nakujaproject/internship2024-2/SOLID PROPULSION/WEEKLY REPORTS/Week 1 and 2 Progress Report_compressed.pdf

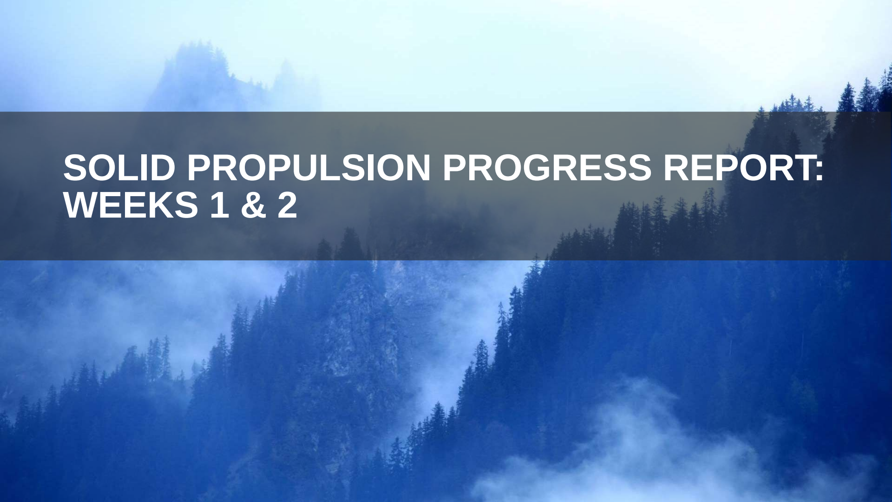
[picture p1: page 1]

## SOLID PROPULSION PROGRESS REPORT: WEEKS 1 & 2

## Week 1 Objectives

### - Orientation - Go through the theory of solid motors - Help in N3.5 launch preparation - Understand N3.5 propulsion system

### Tasks completed in week 1

- Attending orientation meetings
- Reading solid motor theory - Richard Nakka
- Helped N3.5 team prepare for launch
- Installation and training on necessary software -Solidworks, Open Motor, Ansys, etc
- Solid propulsion system characterization for N3.5

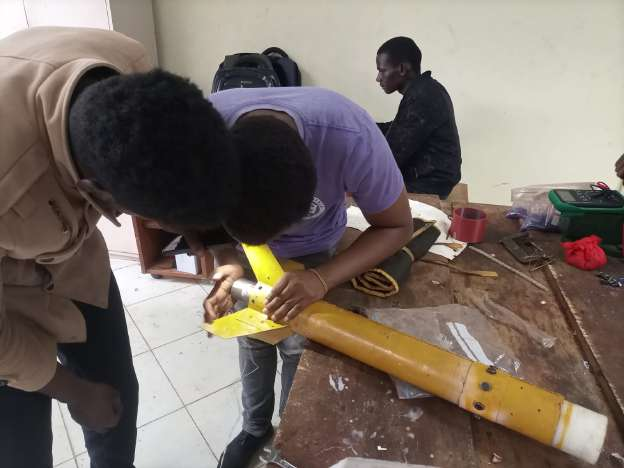
[picture p2: figure]
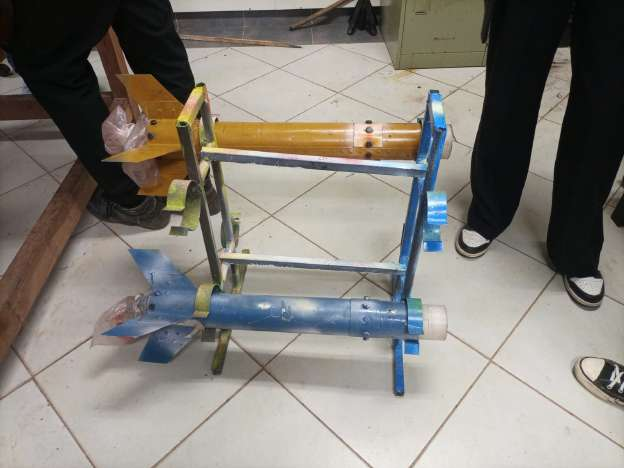
[picture p3: figure]

## Week 2 Objectives

### - Benchmarking solid motor designs - Estimation of required impulse for target apogee - Casing Design - Design of grains and nozzle parameters using Open Motor - Ansys Simulation of flow through nozzle - Design of grain casting tools - Improvements and SA Cup Requirements - Design of Casting Tools

### Tasks Completed in week 2

Benchmarking of SRM designs

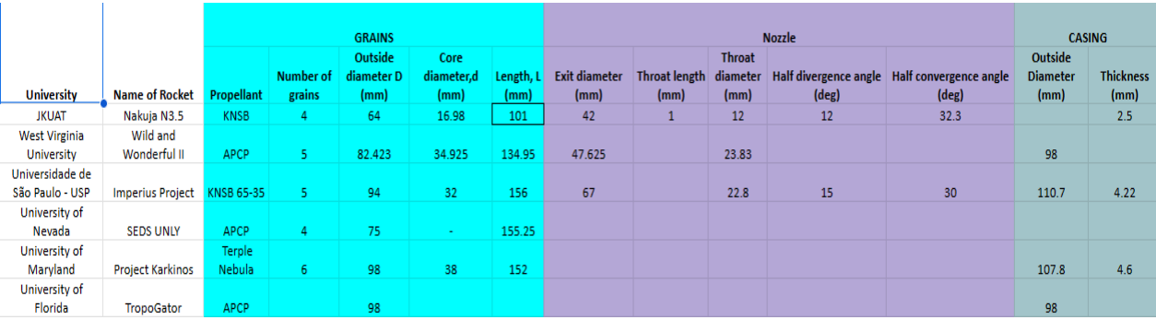
[picture p4: figure]

### Impulse estimation

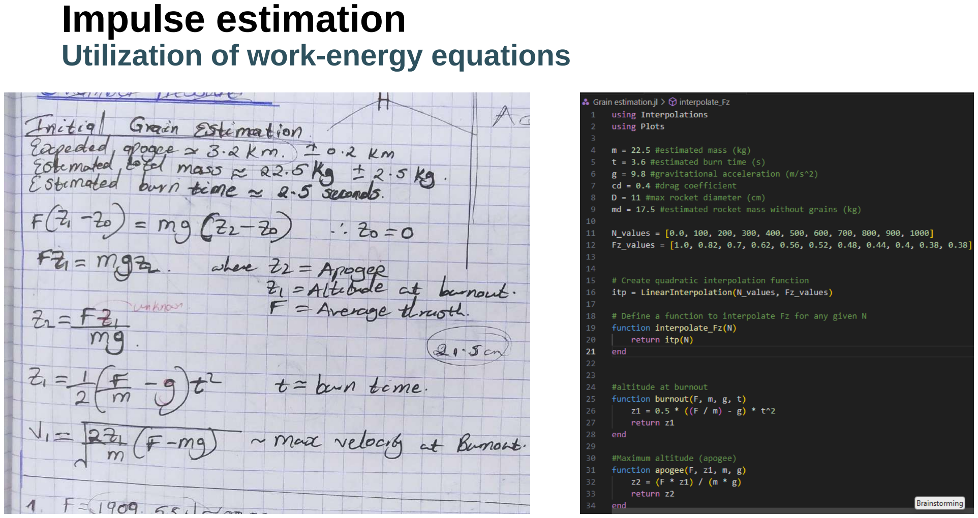
[picture p5: page 6]

Utilization of work-energy equations

Apogee Estimation Results

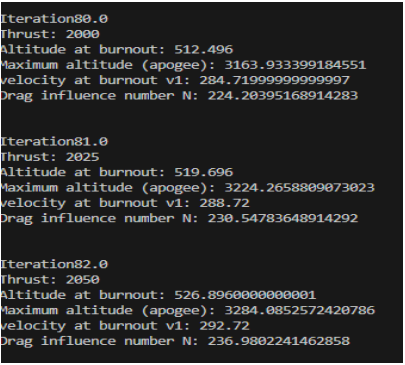
[picture p6: figure]

Burn time (estimate) = 3.6 s

Avg thrust required = 2025 N

Impulse required = 7290 Ns

### Casing Design

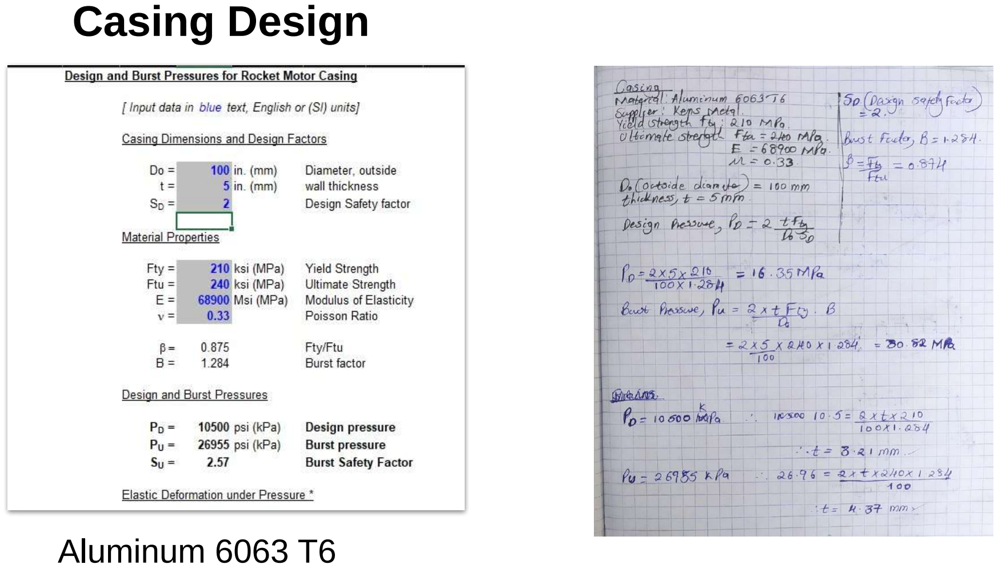
[picture p7: page 8]

Aluminum 6063 T6

### Design of Grains and Nozzle Parameters

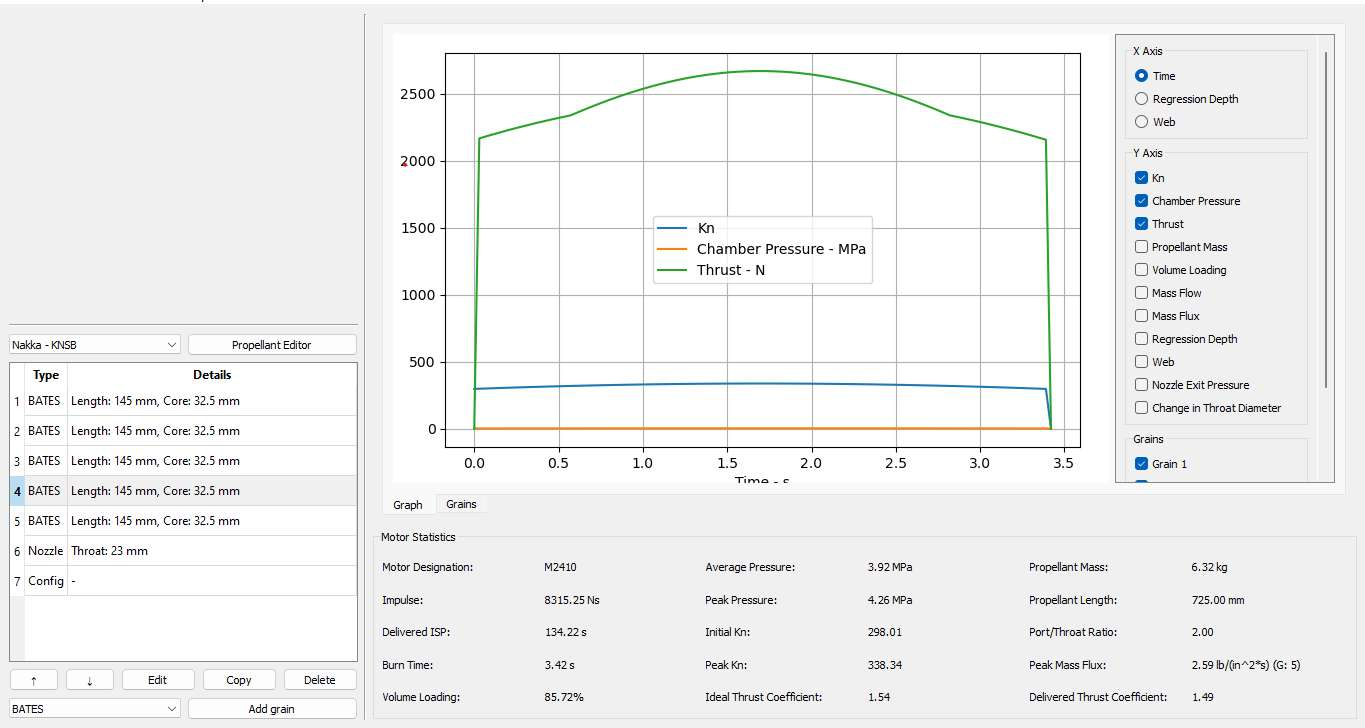
[picture p8: page 9]

### Design of Grains and Nozzle Parameters

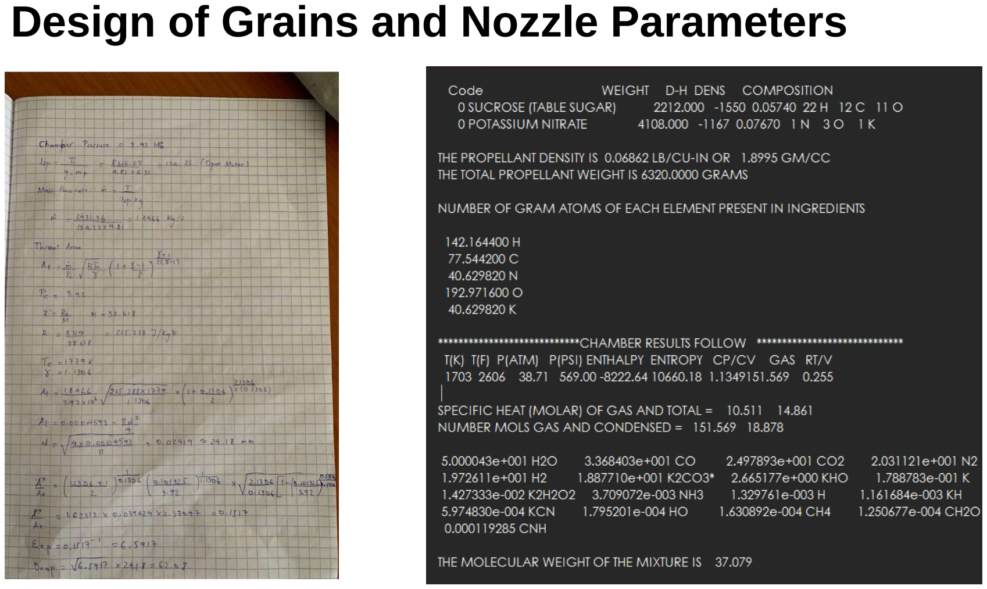
[picture p9: page 10]

### Design of Grains and Nozzle Parameters

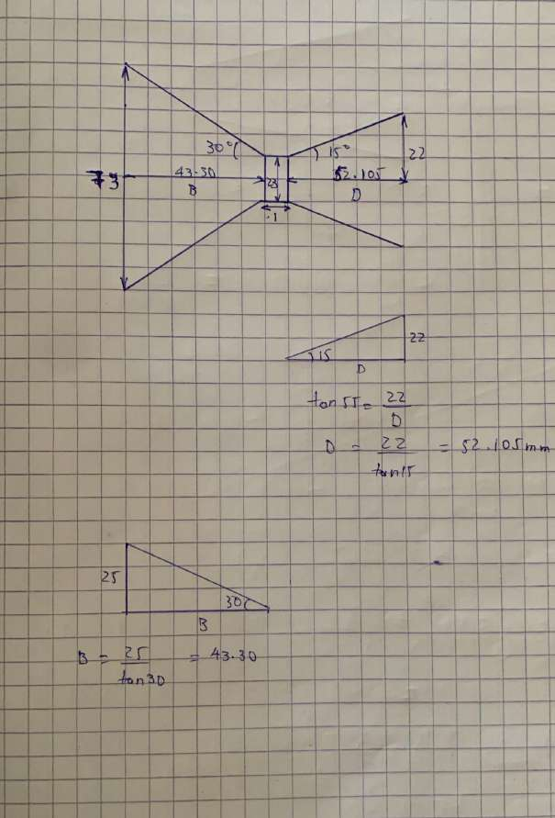
[picture p10: figure]

## Motor dimensions estimation

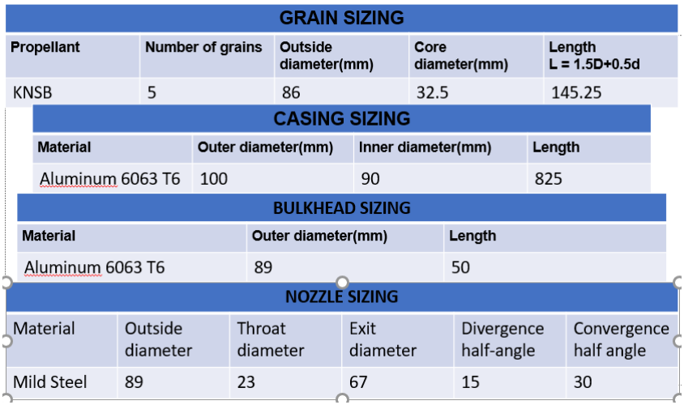
[picture p11: figure]

### Bulkhead and Nozzle drawing

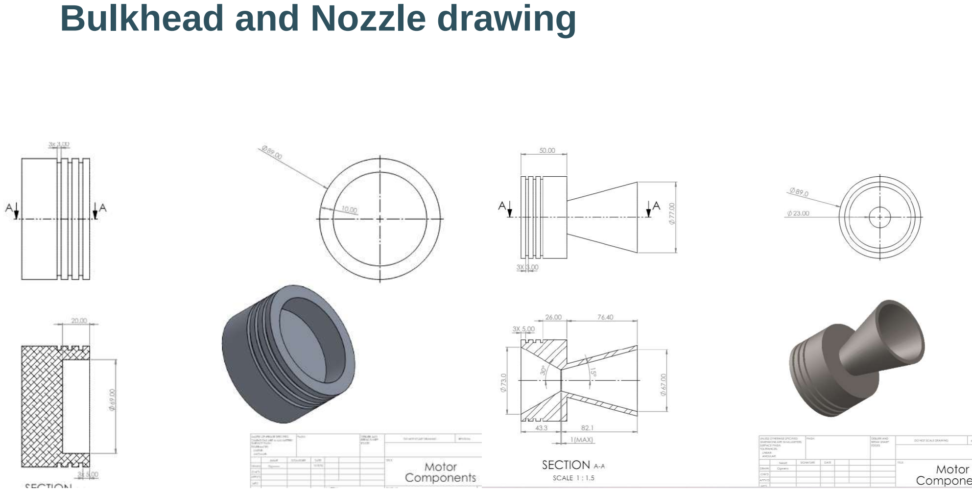
[picture p12: page 13]

### Casing drawing

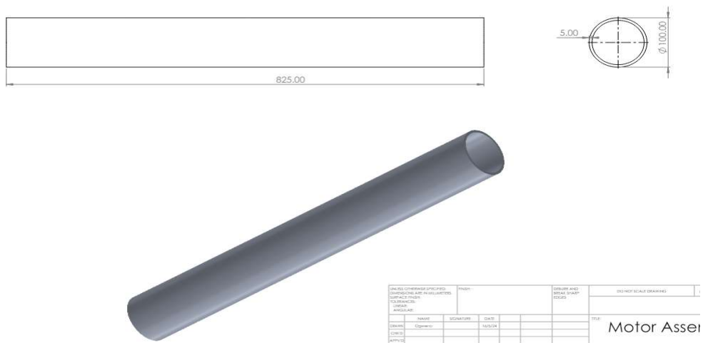
[picture p13: figure]

### Recommendations on N3.5 and SA Cup Requirements

15

Recommendations

- Measuring chamber pressure and temperature
- Measuring casing
temperature
- Redesign of test stand
- Long storage and drying of grains

SA Cup Requirements

SA Cup Requirements - Google Docs (https://docs.google.com/document/d/11p6GHSLXKU7WtKH3MYqem9ddYCUASf99VvVzHWX0Wqg/edit)

Challenges
- Simulation softwares
- Unergonomic seats

### Next Week’s Objectives

16

- Nozzle simulation (Ansys) and characterization
- Coming up with a
components budget
- Procurements of casing,
nozzle and bulkhead
materials
- Test stand design
- Research on grain storage
- Design and 3D printing of Casting tools

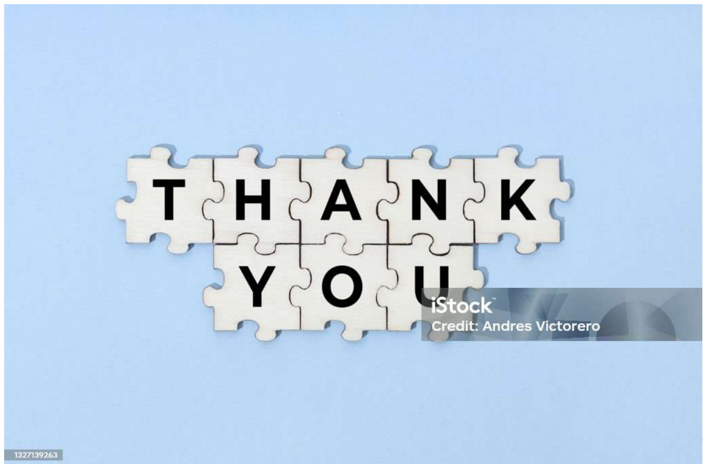
[picture p14: page 17]

17
