nakujaproject/internship2024-2/SOLID PROPULSION/WEEKLY REPORTS/Week 3 Progress Report_compressed.pdf

# N4 - SOLID PROPULSION PROGRESS

### Week 3

## A. WEEK OBJECTIVES

### 1. Design and 3D printing of Casting tools 2. Nozzle simulation (ANSYS) 3. Motor casing design 4. Research on grain storage 5. Bill of material 6. Redesign of ignition circuit

## B. TASKS DONE

### 1. Design and 3D printing of the casting tools

a. Design of the casting tools using SOLIDWORKS

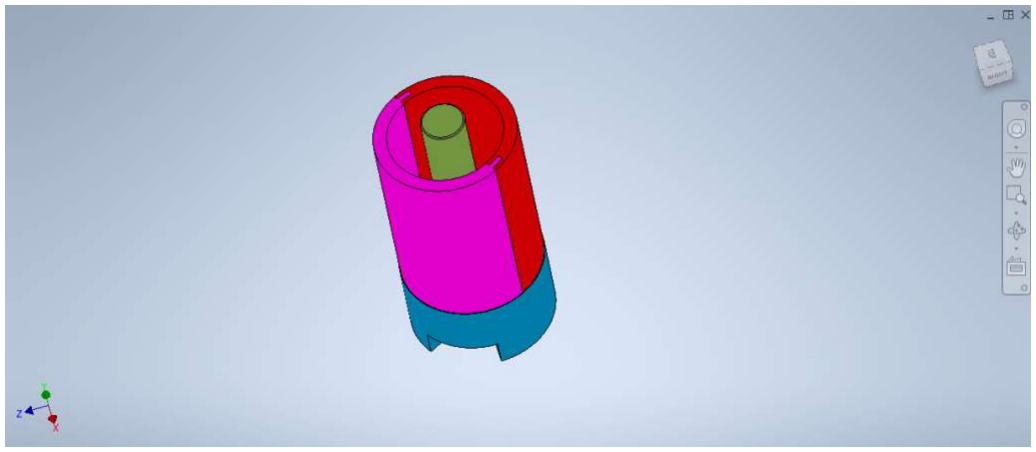
[picture p15: figure]
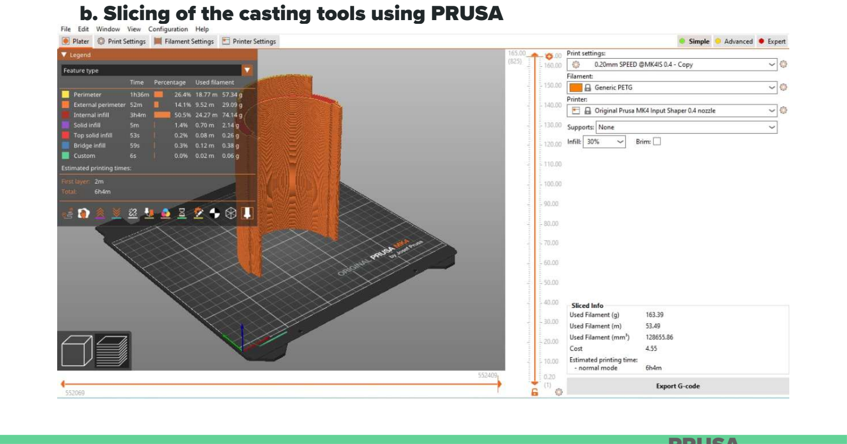
[picture p16: page 4]

b. Slicing of the casting tools using PRUSA

PRUSA

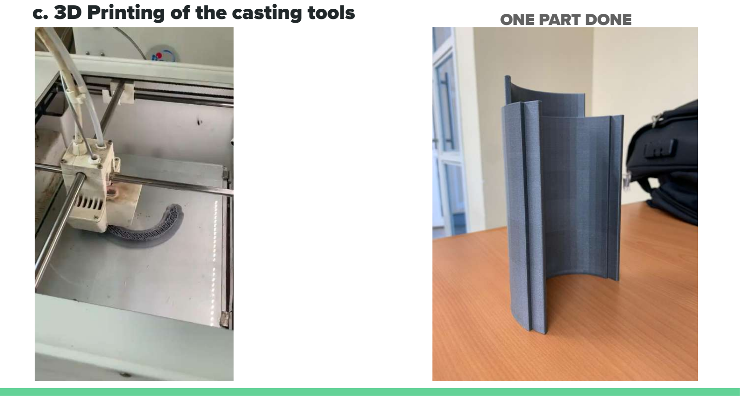
[picture p17: page 5]

c. 3D Printing of the casting tools | ONE PART DONE

### 2. Nozzle simulation

a. Pressure

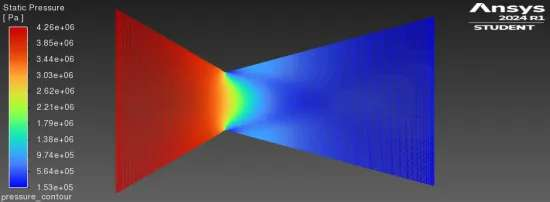
[picture p18: figure]

Map

### 2. Nozzle simulation

a. Pressure

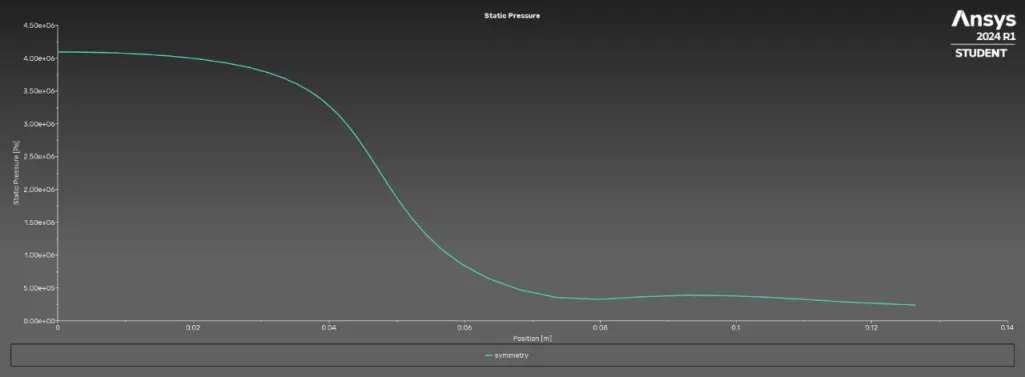
[picture p19: figure]

Map

### 2. Nozzle simulation

b. Velocity

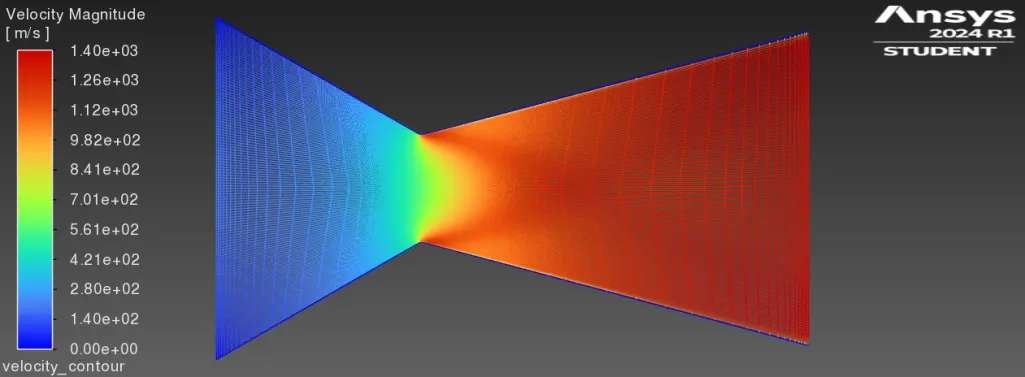
[picture p20: figure]

Map

### 2. Nozzle simulation

b. Velocity

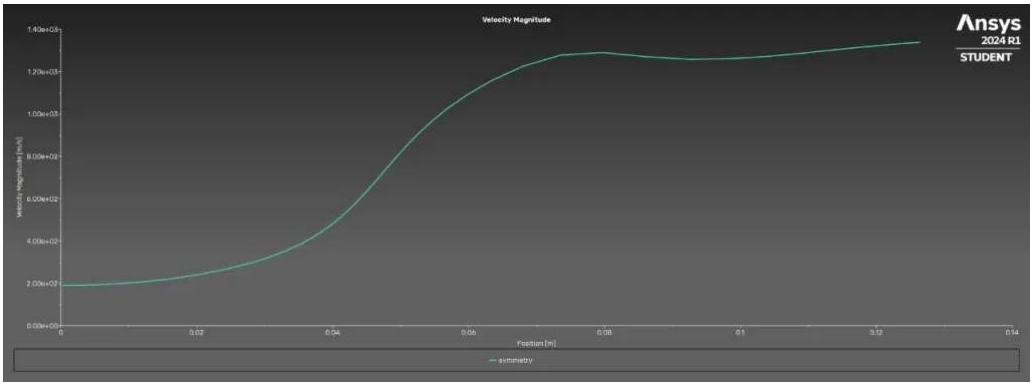
[picture p21: figure]

Plot

### 2. Nozzle simulation

c. Temperature

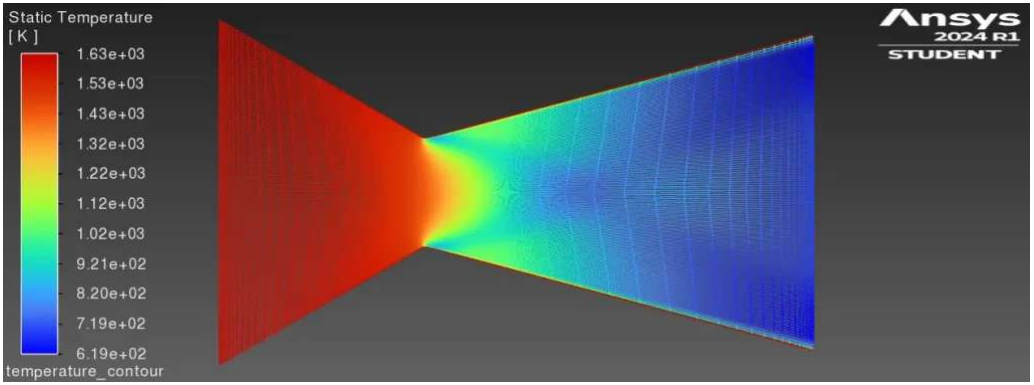
[picture p22: figure]

Map

### 2. Nozzle simulation

c. Temperature

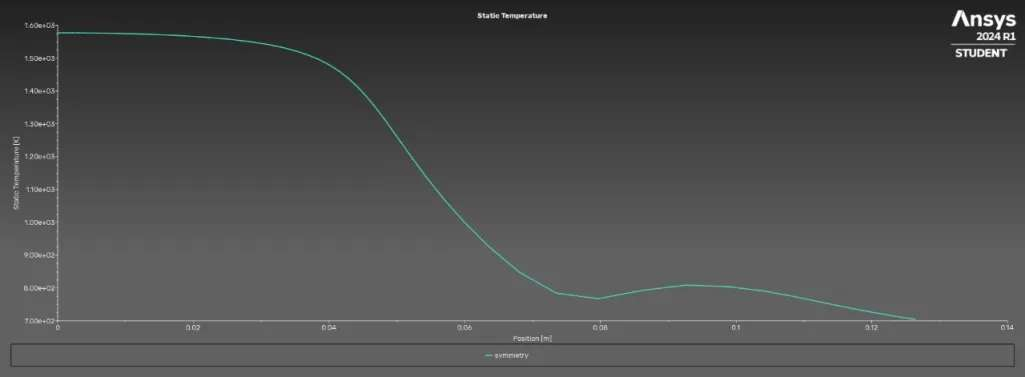
[picture p23: figure]

Plot

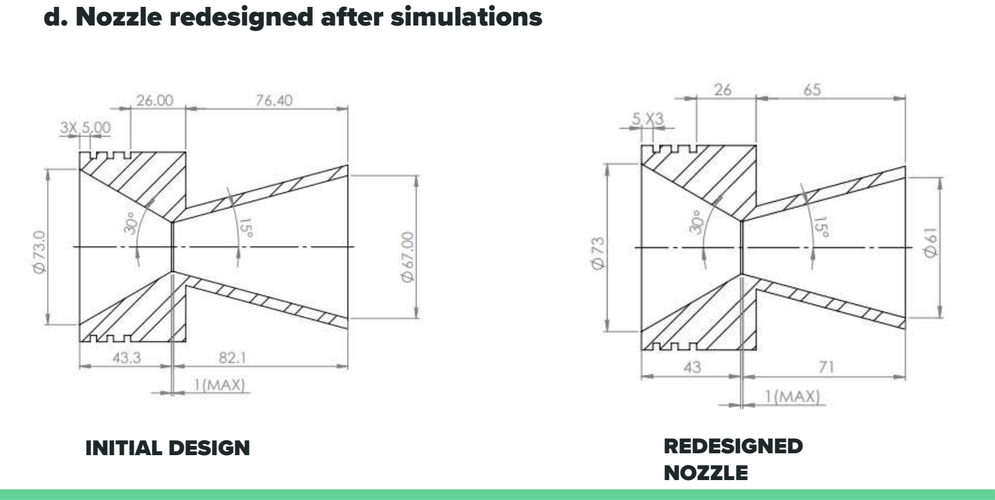
[picture p24: page 12]

d. Nozzle redesigned after simulations

REDESIGNED
NOZZLE

INITIAL DESIGN

## 3. Motor casing design

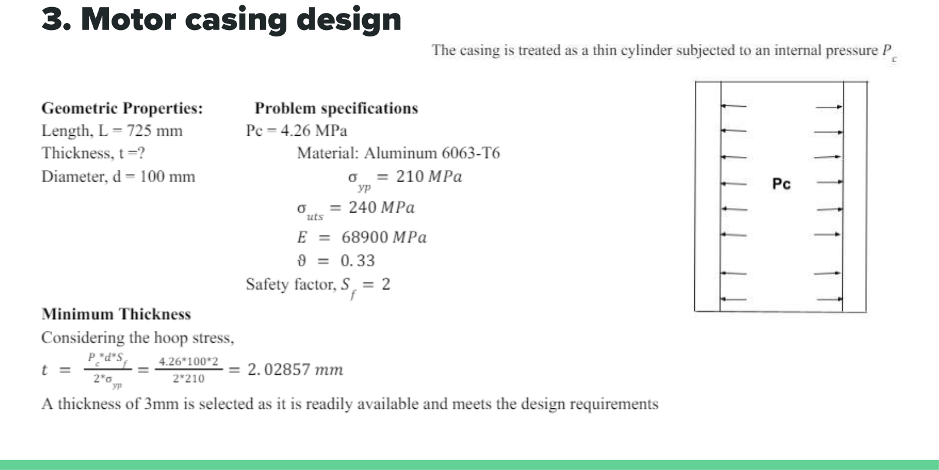
[picture p25: page 13]

## 4. Grain storage

Molecular Sieves- effectively at low humidity levels, expensive
Activated Alumina(Al(OH)3)- porous, good moisture absorption capacity. fragile and prone to crushing
CaSO4- does not form liquid when saturated, low moisture absorption capacity.
CaCl2- (suggested in Richard Nakka). absorb moisture effectively, quite reactive, forms liquid brine with moisture. Concentrated solution is corrosive
Silica Gel- Inert, effective moisture absorption, no liquid formation, easy to handle, nontoxic
https://1drv.ms/w/s!Aq_-ZEYiFHccsRXqFwWScMQ3fxAJ?e=92ZWR1

## 5. Bill of material

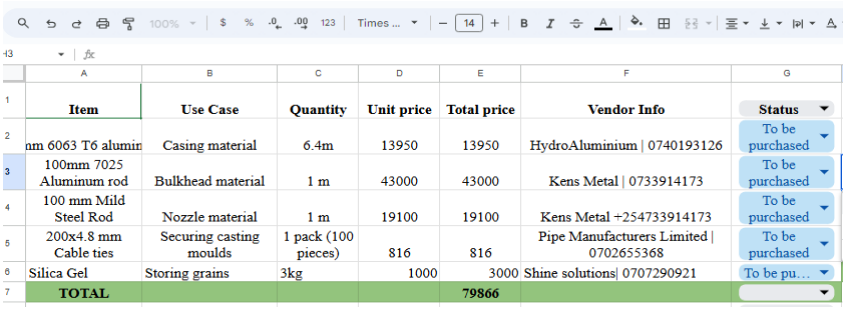
[picture p26: figure]

## 6. Ignition Circuit Improved

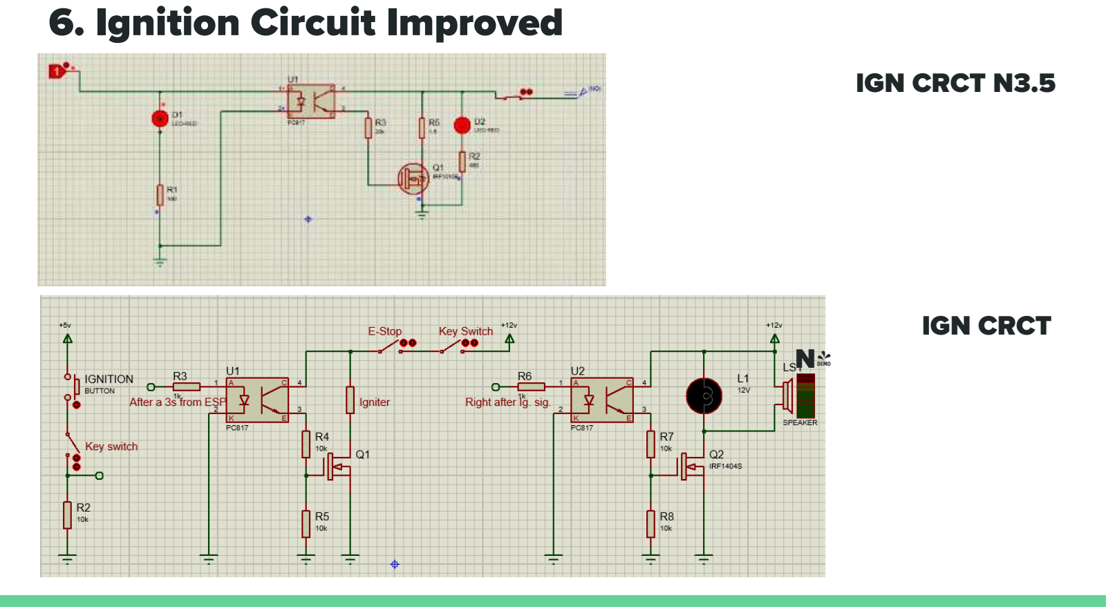
[picture p27: page 16]

IGN CRCT N3.5

IGN CRCT
N4

## C. CHALLENGES

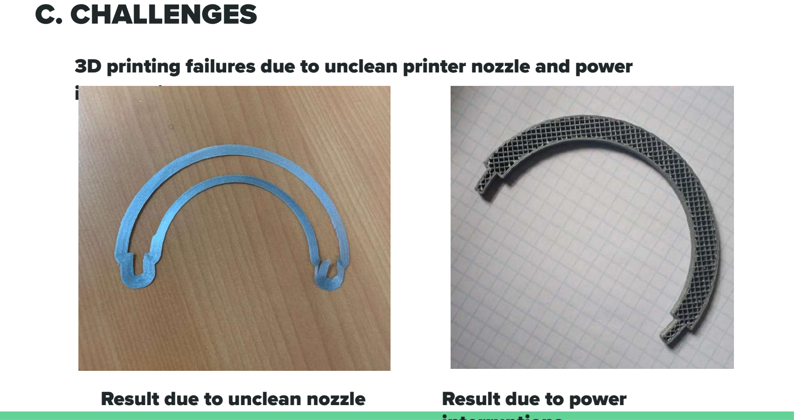
[picture p28: page 17]

3D printing failures due to unclean printer nozzle and power interruptions

Result due to unclean nozzle | Result due to power interruptions

## D. NEXT WEEK OBJECTIVES

### 1. Procurement of the materials 2. Machining of the nozzle, the bulkhead and the motor casing 3. Cooking of the grain 4. Fabrication of the ignition circuit 5. Complete the test stand design and its fabrication

# Arigatō🙏
