nakujaproject/internship2024-2/SOLID PROPULSION/WEEKLY REPORTS/Week 5 Presentation_compressed.pdf

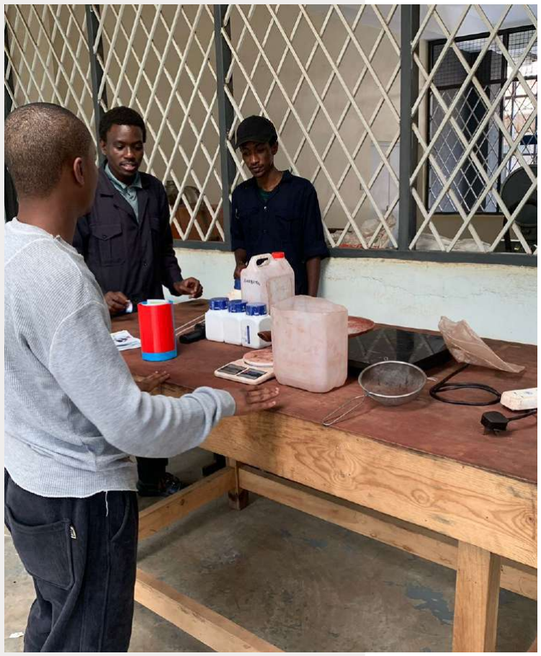
[picture p32: figure]

# Solid Team Week 5 Progress Report

## Created by

# Benard Mburu

# Objectives

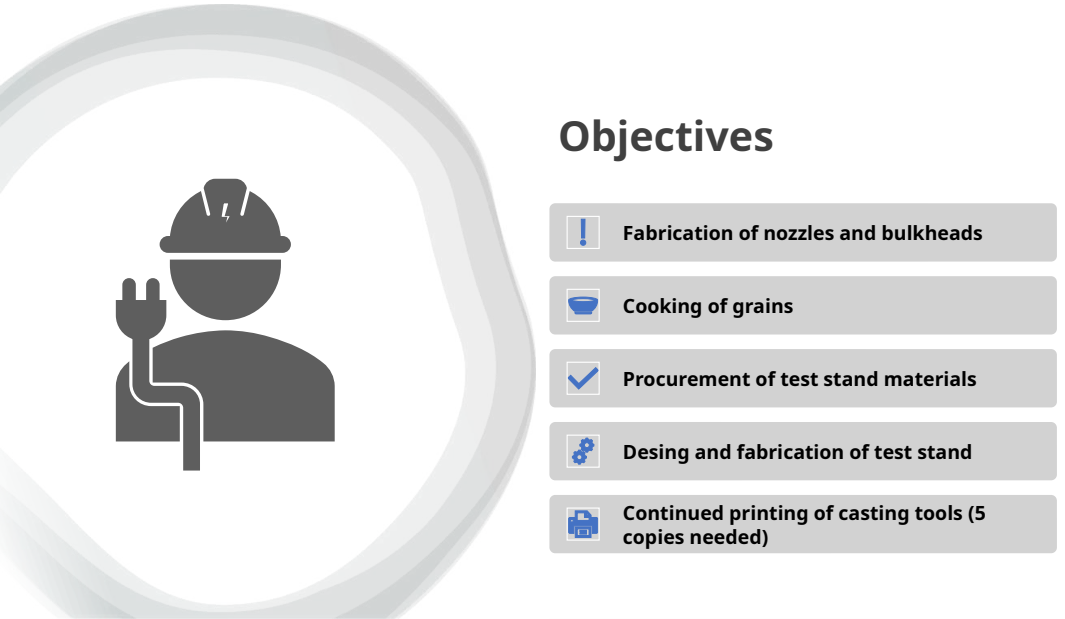
[picture p33: page 2]

Fabrication of nozzles and bulkheads

Cooking of grains

Procurement of test stand materials

Desing and fabrication of test stand

Continued printing of casting tools (5
copies needed)

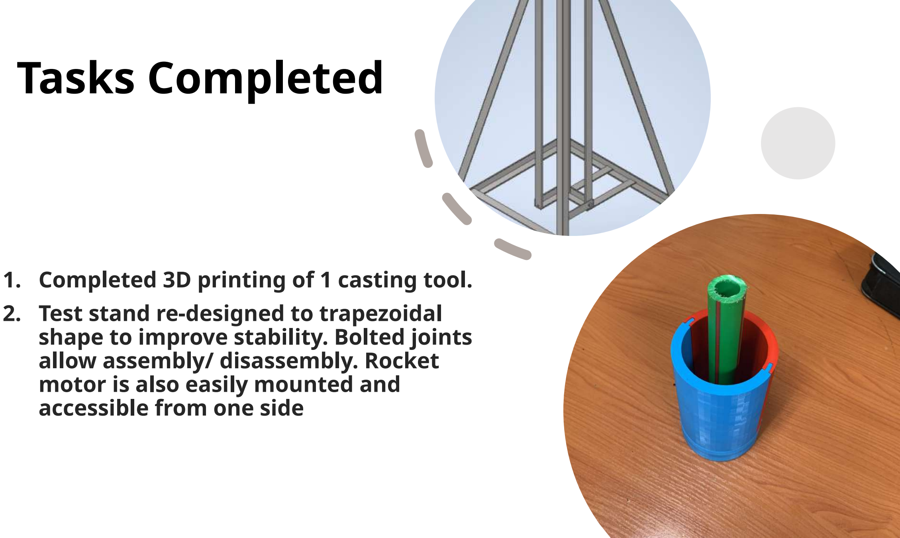
[picture p34: figure]
Tasks Completed; allow assembly/ disassembly. Rocket motor is also easily mounted and accessible from one side

1. Completed 3D printing of 1 casting tool.

# 2. Test stand re-designed to trapezoidal shape to improve stability. Bolted joints

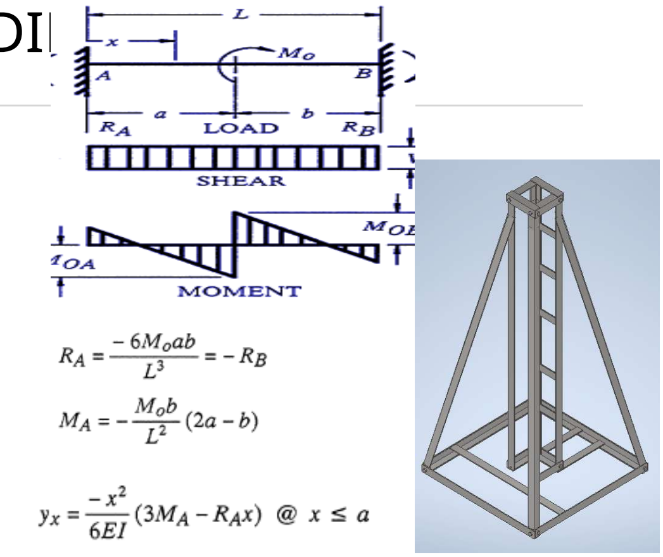
[picture p35: figure]

# TEST STAND LOADING

## Angle beam – 1.25 * 1.25 * 3/16 in L = 600mm

## Max thrust = 2500N --> Safety of 2 :

5000N

## Torque = 750Nm

I = 2.56488*10^-8 m^4

## Ra = 1875N Ma = 187.5Nm Max deflection = 1.5mm

# 3. Material Procurement

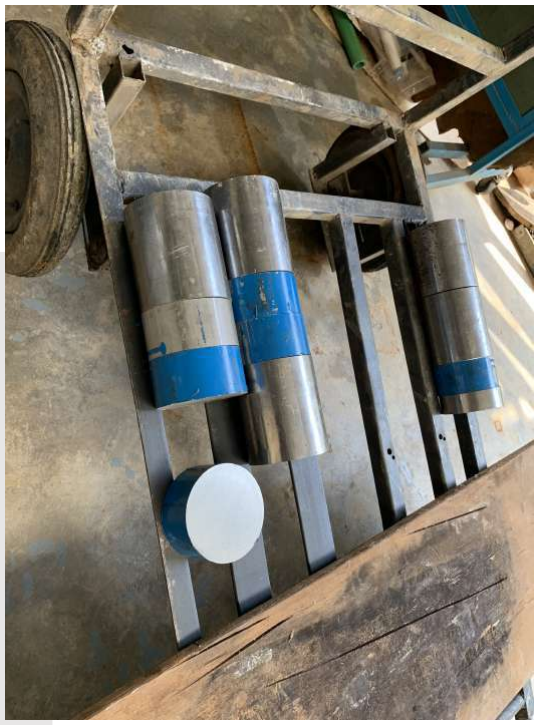
[picture p36: figure]
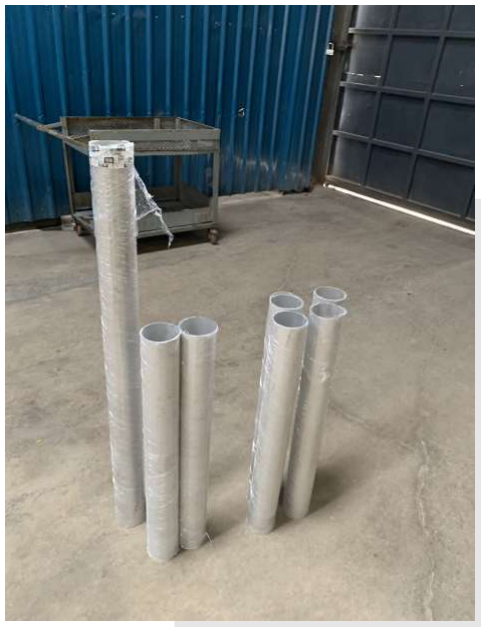
[picture p37: figure]

# The procurement of various materials as listed in the Bill of Materials (BOM) was successfully

completed.

# 4. Updating Inventory

Item name | Quantity | Location | T E A M | Status
Cable Ties | 100 | Rapid Prototyping Room | Solid | In Stock
Epoxy Resin | 750ml | Rapid Prototyping Room | Solid | In Stock
Epoxy Hardener | 250ml | Rapid Prototyping Room | Solid | In Stock
Speaker | 1 | Rapid Prototyping Room | Solid | In Stock
Key switches | 2 | Rapid Prototyping Room | Solid | In stock
Strobe Lights | 4 | Rapid Prototyping Room | Solid | In stock
M8 Bolts | 160 | Rapid Prototyping Room | Solid | In stock
M8 Nuts | 60 | Rapid Prototyping Room | Solid | In stock
Washers | 60 | Rapid Prototyping Room | Solid | In stock
Center Drill | 1 | Machine Shop | Solid | In use
Cutting tools | 2 | Machine Shop | Solid | In use
Drill bit | 1 | Machine Shop | Solid | In use
H/R angle line, Mild Steel, 50x50x6, 6mtr | 1 | Rapid Prototyping Room | Liquid In Use
Drill bit 8mm | 2 | Rapid Prototyping Room | Liquid In Use
Hydrogen Peroxide | 600ml | Rapid Prototyping Room | Solid | In Use
HCL | 1 | Rapid Prototyping Room | Solid | In Use
Acetone | 500ml | Rapid Prototyping Room | Solid | In Use

# 5. Nozzle Fabrication

# Commenced tapering at

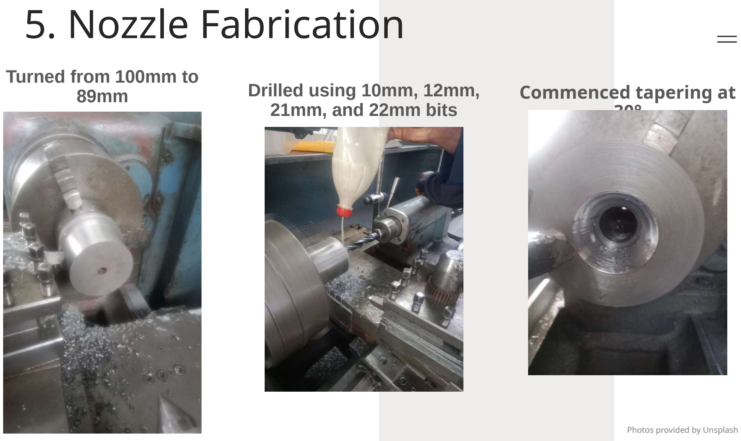
[picture p38: page 7]

30°

Photos provided by Unsplash

Drilled using 10mm, 12mm,

## 21mm, and 22mm bits

## Turned from 100mm to

89mm

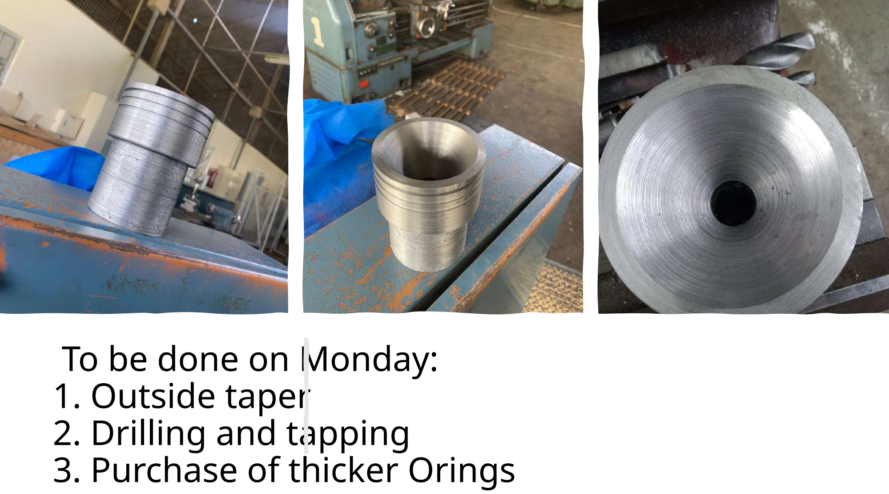
[picture p39: page 8]

# To be done on Monday: 1. Outside taper 2. Drilling and tapping 3. Purchase of thicker Orings

# 6. Fuel Grain Calculations

## Using 15%

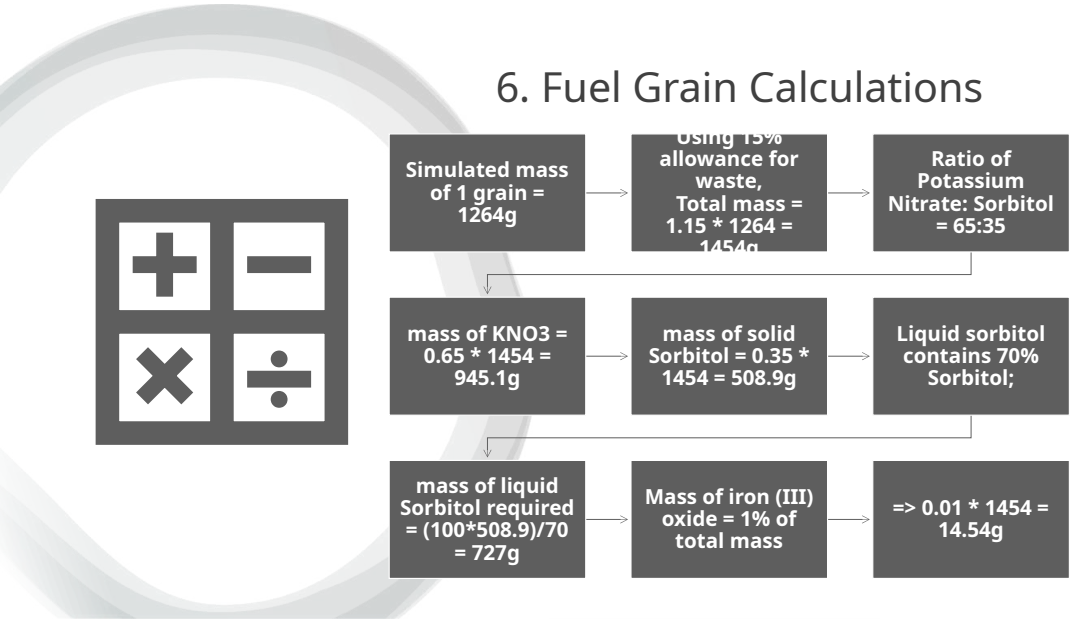
[picture p40: page 9]
Simulated mass of 1 grain = 1264g; allowance for waste, Total mass = 1.15 * 1264 = 1454g; Ratio of Potassium Nitrate: Sorbitol = 65:35; mass of KNO3 = 0.65 * 1454 = 945.1g; mass of solid Sorbitol = 0.35 * 1454 = 508.9g; Liquid sorbitol contains 70% Sorbitol;; mass of liquid Sorbitol required = (100*508.9)/70 = 727g

Mass of iron (III)
oxide = 1% of
total mass

# Grain Cooking Process

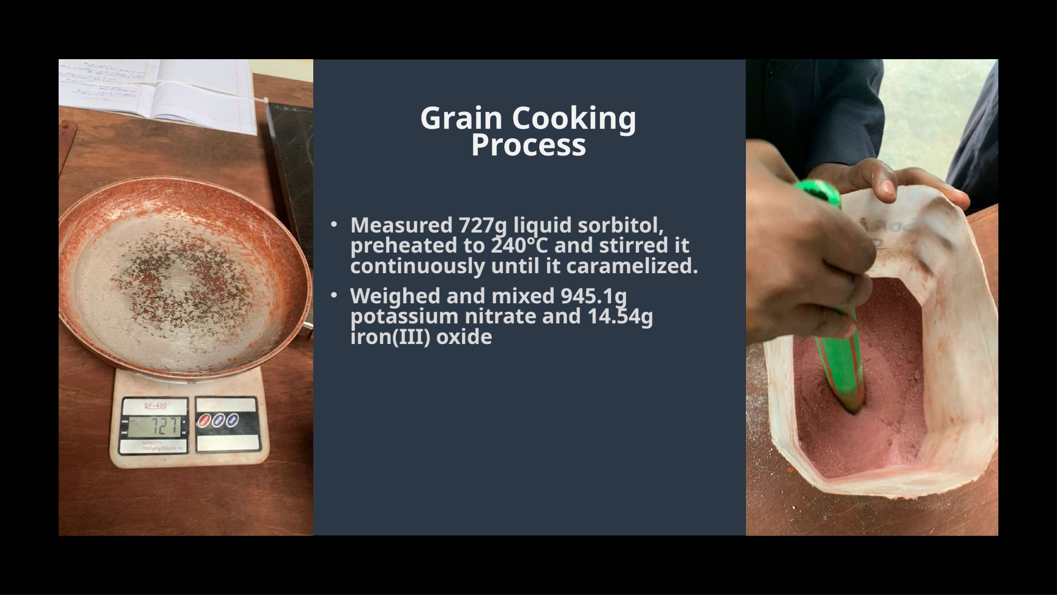
[picture p41: page 10]

- Measured 727g liquid sorbitol,

# preheated to 240°C and stirred it

continuously until it caramelized.

# - Weighed and mixed 945.1g potassium nitrate and 14.54g iron(III) oxide

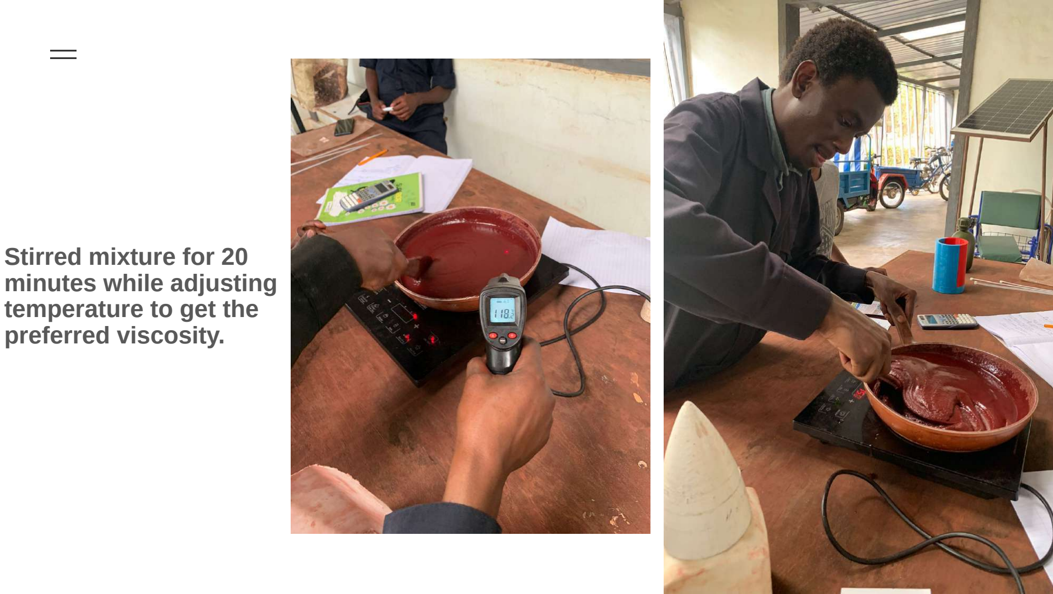
[picture p42: page 11]

## Stirred mixture for 20 minutes while adjusting temperature to get the

preferred viscosity.

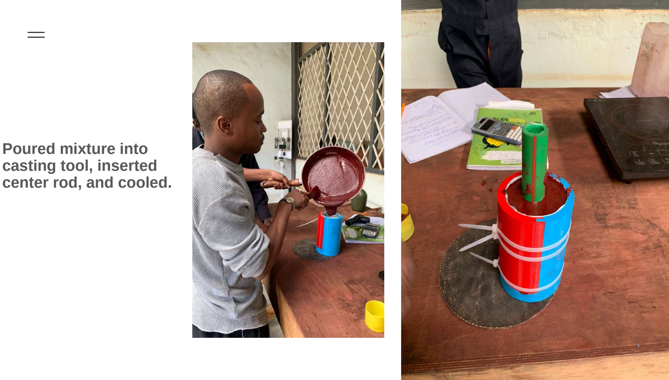
[picture p43: page 12]

## Poured mixture into casting tool, inserted

center rod, and cooled.

# Challenges faced

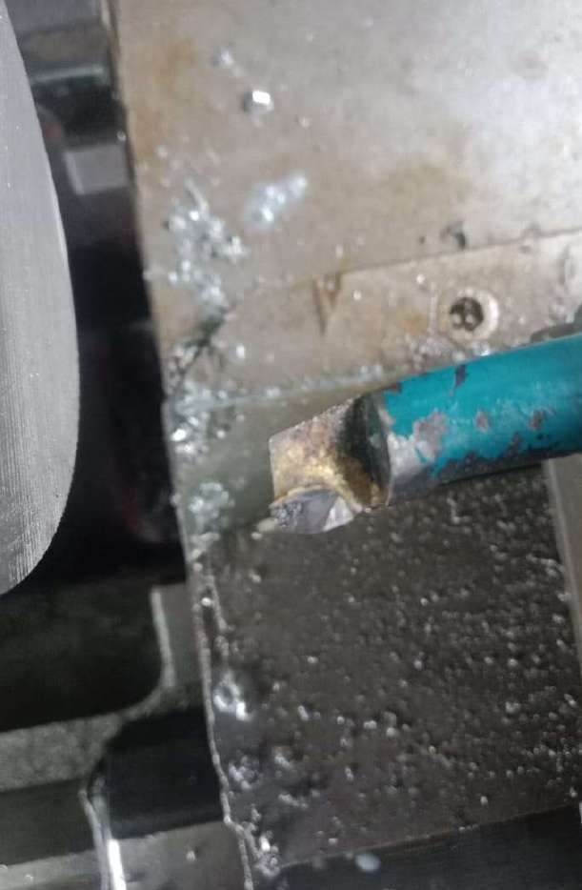
[picture p44: figure]

# 1. Broken boring tool The spindle accidentally reversed direction which took out the tip of the

boring tool.

# Next Steps

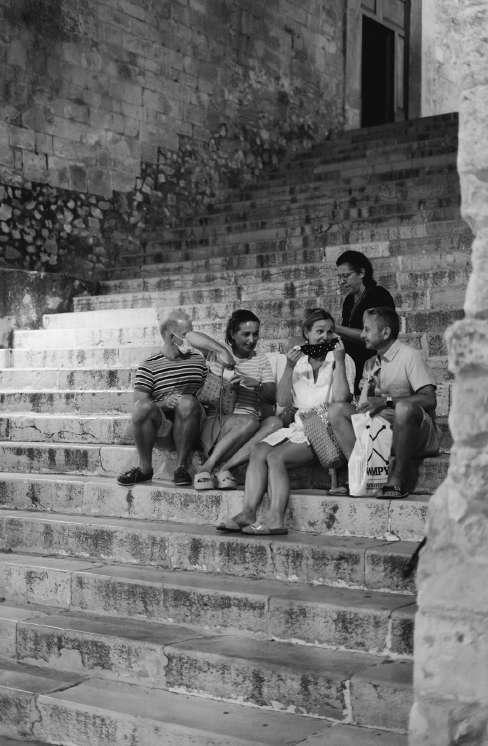
[picture p45: figure]

# - Finish Nozzle and Bulkhead Preparation - Printing of Casting tools - Purchase of Test stand Components and Orings for the nozzle - Assemble and test the newly designed test stand - First Static Test (Tuesday or Wednesday)

Photos provided by Unsplash
