nakujaproject/internship2024-2/SOLID PROPULSION/WEEKLY REPORTS/WEEK 6 REPORT_compressed.pdf

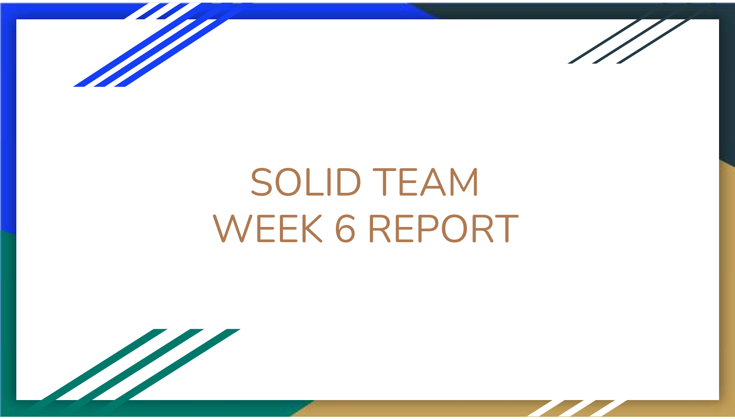
[picture p46: figure]
SOLID TEAM WEEK 6 REPORT

# OBJECTIVES

## 1. Fabricating Bulkhead 2. Complete fabricating the nozzle 3. Re-designing the test stand 4. Procuring items 5. Assembling the motor 6. Performing first static test

# 1. Fabricating the Bulkhead

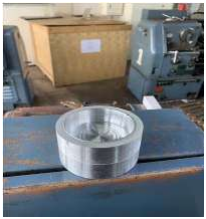
[picture p47: figure]

Bulkhead

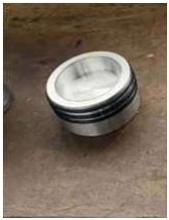
[picture p48: figure]

# 2. Fabricating the Nozzle

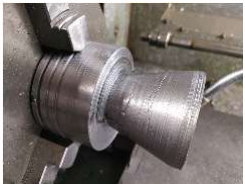
[picture p49: figure]

### Nozzle

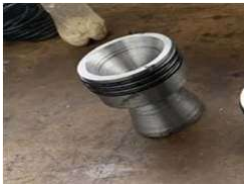
[picture p50: figure]

# 3. Fabricating the Test Stand

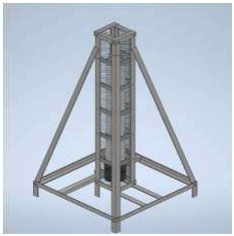
[picture p51: figure]

The test stand design

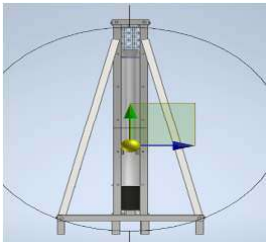
[picture p52: figure]

# 4. Procuring Items

Initially purchased O-rings failed because they weren’t strong and were of large diameter

Ziplocks were purchased for storing the grains

Silica gel for drying the grains

*KNO3 needed for cooking more grains

# 5. Assembling the Motor

Cut the Aluminium tube to a length for one grain

Grooving the nozzle and bulkhead to fit the O-Rings

Drilling the nozzle, bulkhead and casing

Testing the ignition circuit, data transmission and load cell code

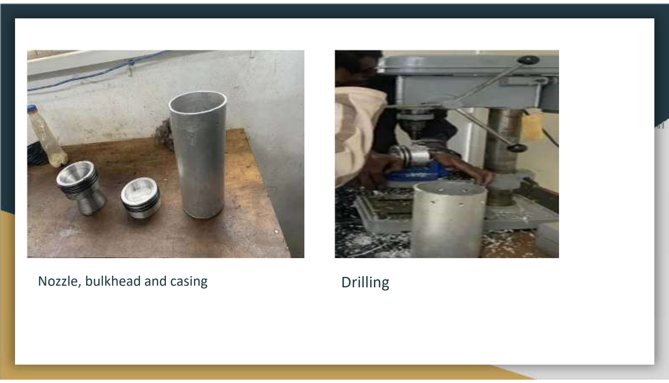
[picture p53: page 8]

Nozzle, bulkhead and casing | Drilling

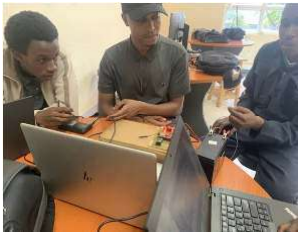
[picture p54: figure]

Testing Ignition Circuit

We opted to use the electrical components and code for N3.5 before any improvement
To avoid errors

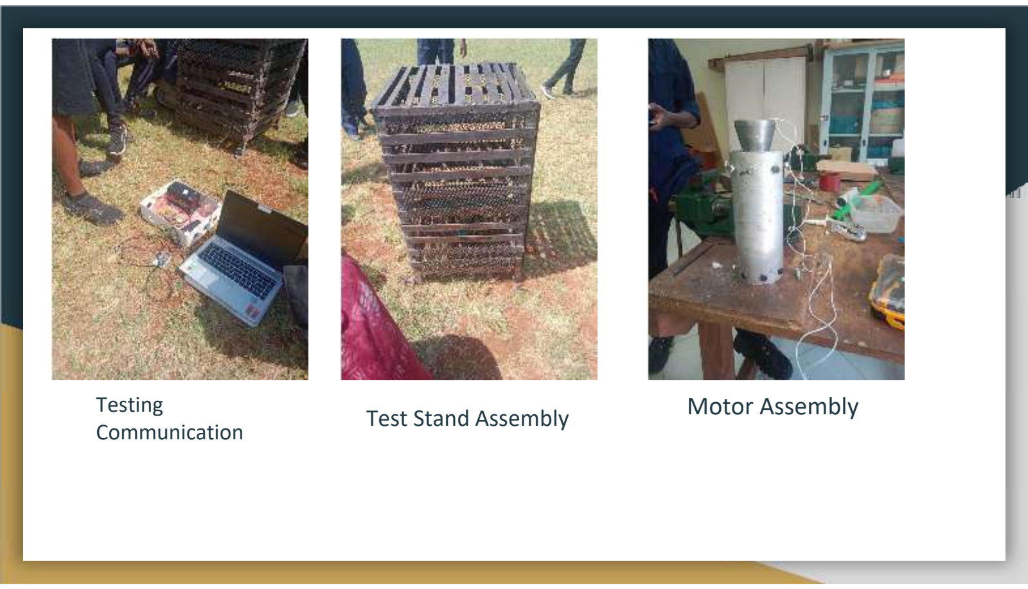
[picture p55: page 10]

Testing
Communication | Test Stand Assembly | Motor Assembly

# 6. Static Test

Done on 14th-June 1359Hours

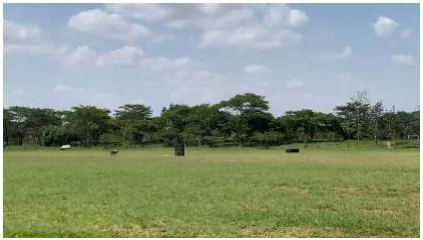
[picture p56: figure]

# Challenges Encountered

### 1. The casting tool design failed and had to be redesigned

### LATHE MACHINE OPERATION $ SAFETY GUIDELINE - Google Docs

### 1. Fabrication delayed due to mechanical damage on Lathe machine

# Next Week Objectives

### 1. Continue cooking the grain 2. Fabricate second nozzle and bulkhead 3. Analysis of the static Test

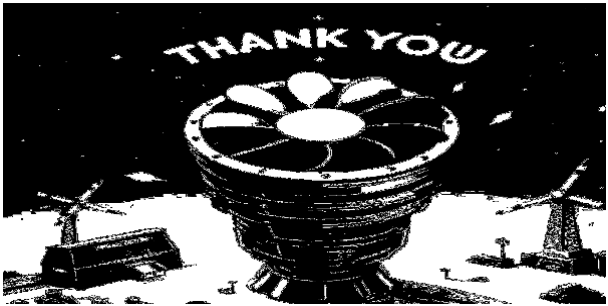
[picture p57: figure]
