nakujaproject/internship2024-2/SOLID PROPULSION/Design Calculations/Casing Design.pdf

Casing Thickness Calculation The casing is treated as a thin cylinder subjected to an internal pressure P
c

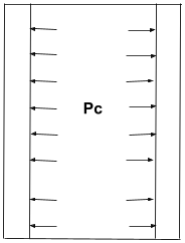
[picture p59: figure]

Geometric Properties: | Problem specifications
Length, L = 725 mm | Pc = 4.26 MPa
Thickness, t =? | Material: Aluminum 6063-T6
Diameter, d = 100 mm | σ
yp = 210 MPa

σ

uts = 240 MPa

E = 68900 MPa
ϑ = 0. 33
Safety factor, S
f = 2
Minimum Thickness
Considering the hoop stress,

t =

P
c

*d*S
f
2*σ
yp

=

4.26*100*2
2*210 = 2. 02857 mm
A thickness of 3mm is selected as it is readily available and meets the design requirements

Expected change in length

∆l =

P
c

*d*l

4*t*E

(1 − 2ϑ) =

4.26*100*725
4*3*68900 = 0. 127 mm

Expected change in diameter

∆d =

P
c

*d

2

4*t*E

(2 − ϑ) = 0. 086 mm
Burst Pressure
P

B =

2*t*σuts
d =

2*3*240
100 = 14. 4 MPa
