nakujaproject/internship2024-2/SOLID PROPULSION/Design Calculations/Nozzle Design_2.pdf

# Nozzle Design

# Introduction

A de-Laval nozzle designed for the Nakuja N4 rocket was simulated in Ansys Fluent Software and throat and exit characteristics of the flow were determined. The purpose of the nozzle is to accelerate the products of combustion thus trading pressure for velocity to maximise the thrust generated. Considerations for the expansion ratio, έ which is the ratio of the nozzle exit area, Ae to that of the nozzle throat area, At.

# Nozzle Design

The operating chamber pressure and Specific impulse were determined first using Open Motor,

P

c = 4. 26 MPa

I

sp = 134. 83 s

Mass Flowrate,

ṁ =

I
I
sp

*g =

2431.36
134.22*9.81 = 1. 8466 kg/s

Optimum throat area for sonic transition,

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
* 1 +

γ−1

( 2 )

γ+1
2(γ−1)

The specific gas constant of the combustion mixture is determined by,

R = where, M is the molecular weight = 35.361 g/mol (from Proprep)

Ro
M
And R is the universal gas constant = 8.314 J/mol.K o

R =

8.314
35.361*10

−3 = 235. 1178 J/Kg. K

Chamber static temperature during combustion,

T

c = 1595 K

Ratio os specific heats,
γ = 1. 1369 (from Proprep) Optimum throat diameter,

A

t =

1.8466
4.26*10

6 *

235.1178*1595
1.1369

* 1 +

1.1369−1

( | 2 | )

1.1369+1
2(1.1369−1) = 4. 17883 * 10

−4
m

2

Throat diameter,

d =

4*4.17883*10

−4
( | )
π | = 23. 1 mm

Optimum throat to exit area ratio,

A
t
A
e

=

γ+1

( 2 )

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
( γ−1 ) * 1 −

P
e
P
c

( )

γ−1

⎡ | γ
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
1.1369+1

( 2 )

1
1.1369−1
*

101325
4.26*10

( 6 )

1
1.1369
*

1.1369+1

( 1.1369−1 ) * 1 −
101325
4.26*10

( 6 )

1.1369−1

⎡ | 1.1369
⎢
⎢
⎣

⎤
⎥
⎥
⎦

= 0. 14395

Optimum expansion ratio,

ε

opt =

A
t
A
e

( )

−1
= 0. 14395

−1 = 6. 947

Exit diameter,

De = | ε * d = | 6. 947 * 23. 1 = 60. 9 mm ≅ 61 mm
