nakujaproject/internship2024-2/SOLID PROPULSION/Design Calculations/Temperature_and_Pressure_sensors.pdf

## Temperature and Pressure sensors

1.Pressure sensor: 626-18-GH-P1-E1-S1 Price: KES 30,901.01

## SPECIFICATIONS

Ships Factory Direct | No
Manufacturer Part Number | 626-18-GH-P1-E1-S1
Item Number | 626-18-GH-P1-E1-S1
Manufacturer | Dwyer Instruments
Family Series | Dwyer Instruments Sensors
Accuracy | 0.25 %
Pressure Range | 0-3,000 psi
Output | 4-20 mA
Process Connection | 1/4 NPT Male
Display | No
Max Pressure | 6,000 psig
Supply Voltage | 10-30 VDC
Electrical Connection | Cable
NEMA Rating | NEMA 4X
IP Rating | IP66
Temperature Range | 0-200 °F
Approvals | CE, NSF, UL
Net Weight | 0.625 lbs
Gross Weight Supplier | 0 lbs
| www.galco.com

## 2.Temperature Sensor: MAX6675 Price: ~ 1000 ksh

DESCRIPTION:

- Working voltage: DC5V
- Operating Current: 50mA
- The temperature measuring range: -200°C - 1300 °C [Test procedure for 0-1023 °C]
- The temperature measurement accuracy: ± 1.5 °C
- The temperature resolution: 0.25 °C
- The output mode: SPI digital signal
- With fixed mounting holes for easy fixed installation.
- Storage temperature: -50 ~ 150 °C
- The module weight: 4g
- Module size: 25mm * 15mm * 13mm
- This module is only for reference routines and instructions, please note left after shoot-mail or contact sales technical hair item.

Regarding its range, this temperature sensor can only be used for casing temperature, not for the chamber temperature.
