nakujaproject/internship2024-2/SOLID PROPULSION/CAD Files/Casing.SLDPRT

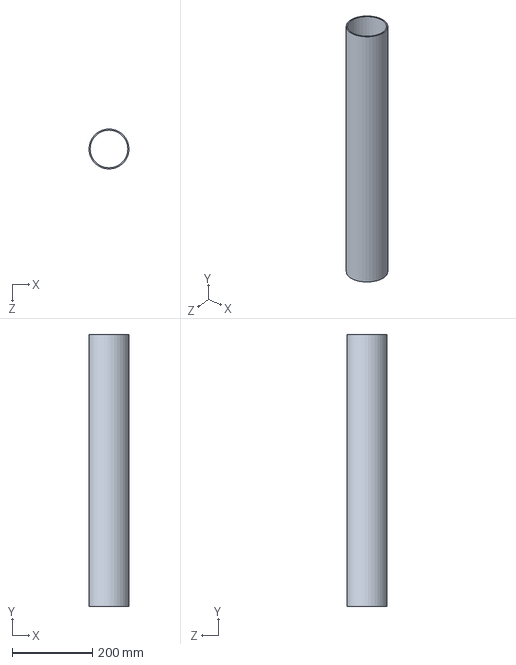
[picture p60: CAD file, 2024-06-21]
SOLID PROPULSION/CAD Files/Casing.SLDPRT
99.9 x 680.0 x 100.0 mm
