nakujaproject/internship2024-2/SOLID PROPULSION/CAD Files/oct 2024/Bulkhead (1).SLDPRT

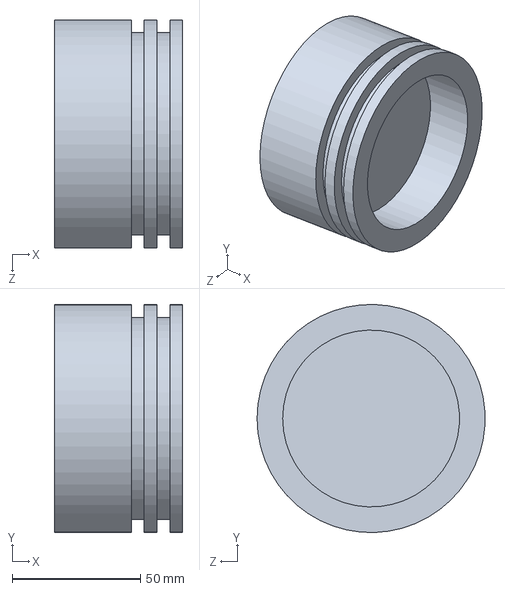
[picture p61: CAD file, 2024-10-10]
SOLID PROPULSION/CAD Files/oct 2024/Bulkhead (1).SLDPRT
50.0 x 89.0 x 88.9 mm
