nakujaproject/internship2024-2/SOLID PROPULSION/CAD Files/Nozzle2.SLDPRT

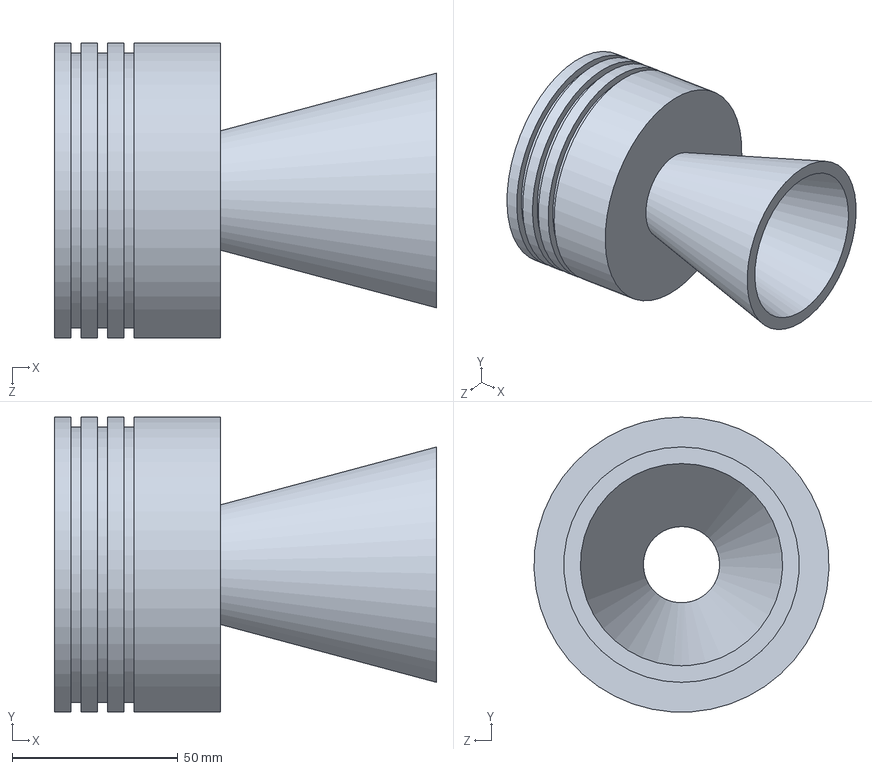
[picture p62: CAD file, 2024-06-21]
SOLID PROPULSION/CAD Files/Nozzle2.SLDPRT
115.2 x 88.9 x 88.9 mm
