nakujaproject/internship2024-2/SOLID PROPULSION/CAD Files/oct 2024/Nozzle2 (1).SLDPRT

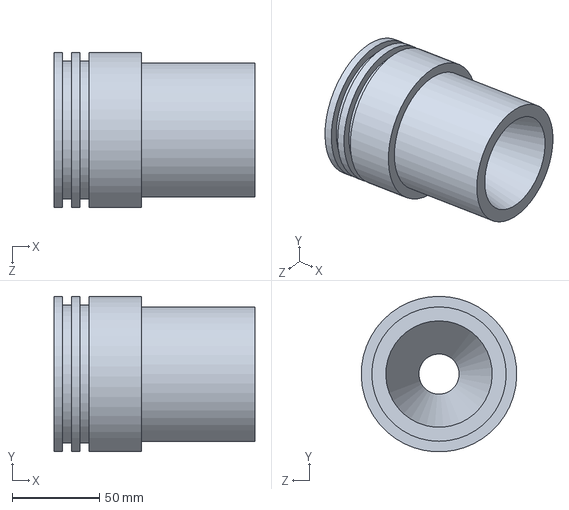
[picture p63: CAD file, 2024-10-10]
SOLID PROPULSION/CAD Files/oct 2024/Nozzle2 (1).SLDPRT
115.0 x 88.9 x 89.0 mm
