nakujaproject/internship2024-2/SOLID PROPULSION/CAD Files/Bulkhead.SLDPRT

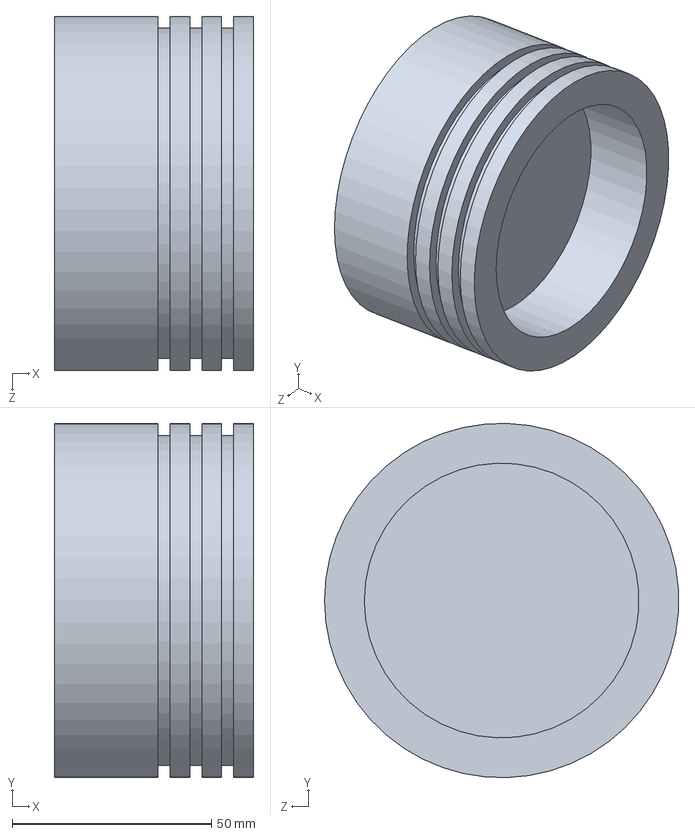
[picture p64: CAD file, 2024-06-21]
SOLID PROPULSION/CAD Files/Bulkhead.SLDPRT
50.0 x 89.0 x 88.9 mm
