nakujaproject/internship2024-2/(list of files, cad)

Other CAD files:
SOLID PROPULSION/CAD Files/Bulkhead_Drawing.SLDDRW
SOLID PROPULSION/CAD Files/Casing_drawings.SLDDRW
SOLID PROPULSION/CAD Files/Nozzle2_Drawing.SLDDRW
