nakujaproject/internship2024-2/SOLID PROPULSION/CAD Files/oct 2024/Nozzle2_Drawing_redesigned (1).PDF

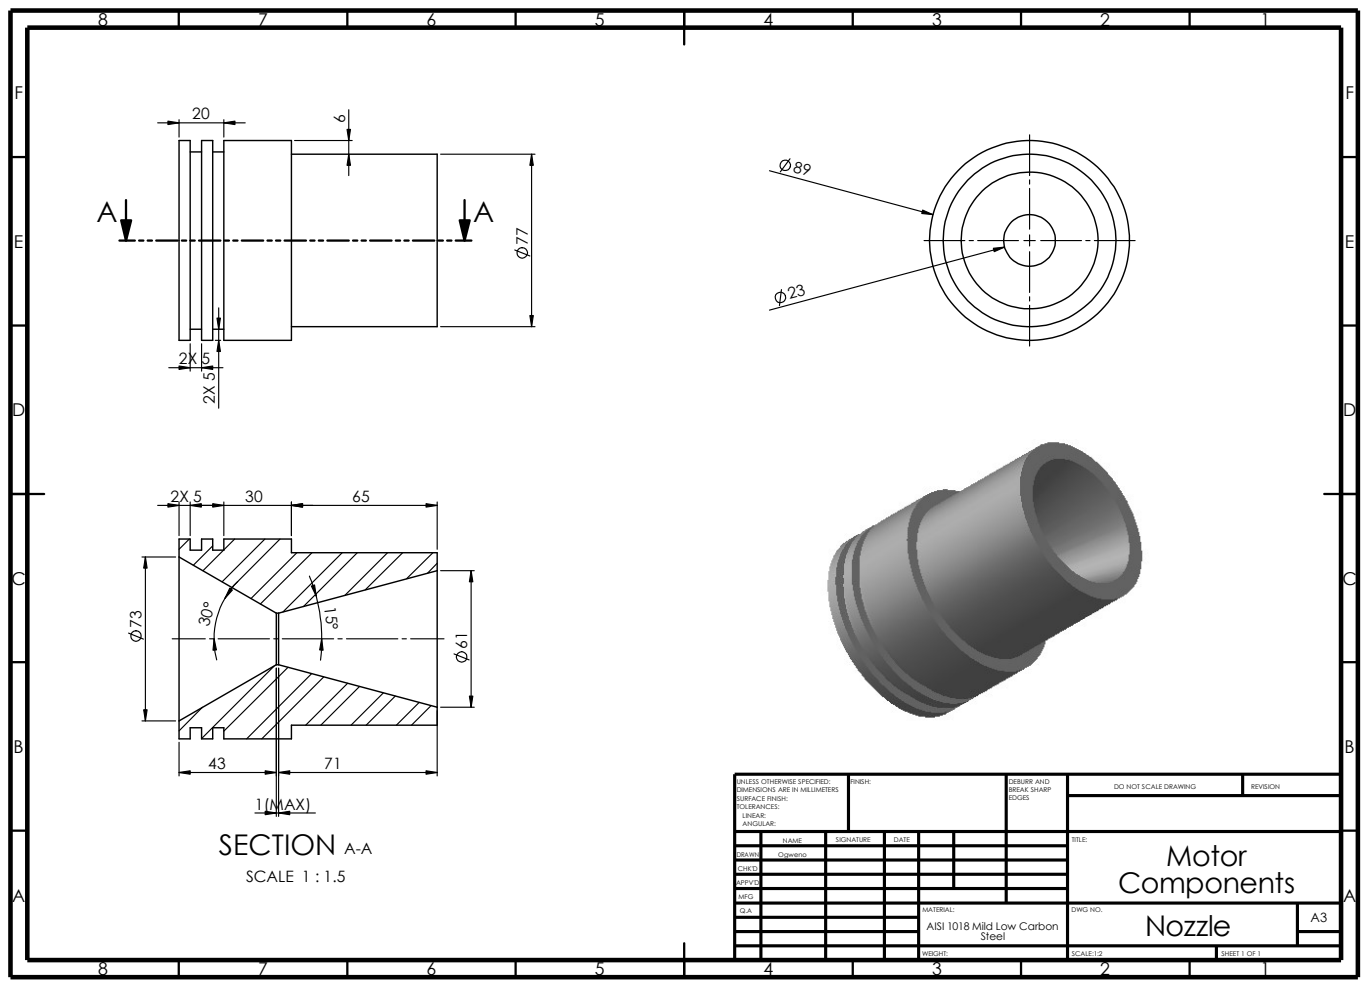
[picture p65: page 1]
WEIGHT:; FINISH:; EDGES; DO NOT SCALE DRAWING; REVISION; SHEET 1 OF 1; BREAK SHARP; SCALE:1:2; DEBURR AND; Components ⁶; SECTION A-A; SCALE 1 : 1.5; 1(MAX)

UNLESS OTHERWISE SPECIFIED:
DIMENSIONS ARE IN MILLIMETERS
SURFACE FINISH:
TOLERANCES:
LINEAR:
ANGULAR:

DRAWN | Ogweno
CHK'D
APPV'D
MFG
Q.A | | | | MATERIAL: AISI 1018 Mild Low Carbon Steel | DWG NO. Nozzle | A3

NAME | SIGNATURE | DATE | | | | TITLE: Motor
