nakujaproject/internship2024-2/SOLID PROPULSION/CAD Files/oct 2024/Bulkhead_Drawing (1).pdf

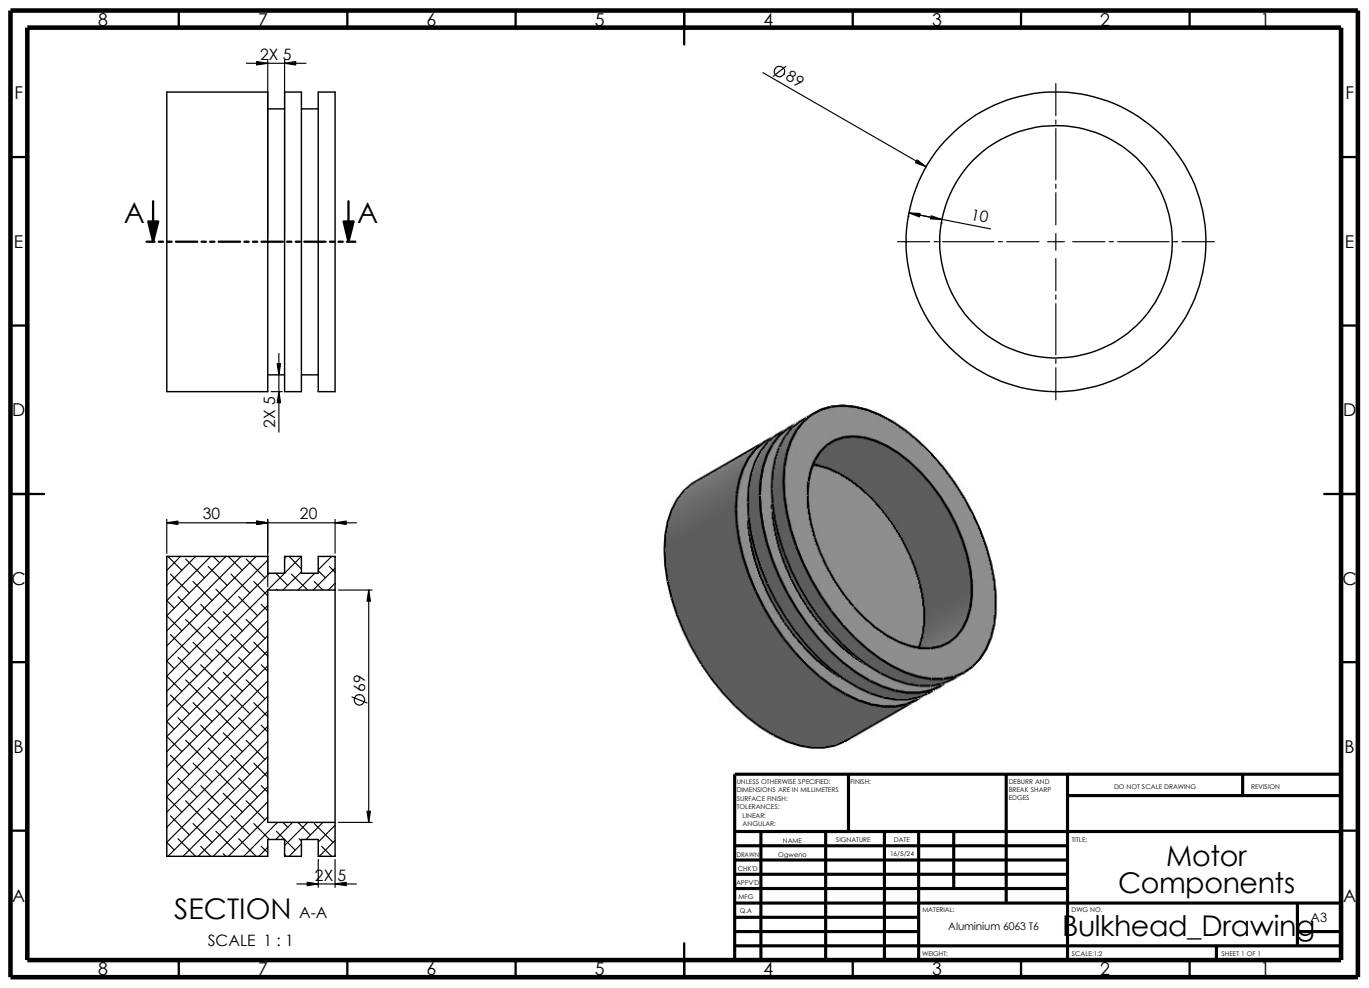
[picture p66: page 1]
CHK'D; FINISH:; EDGES; DO NOT SCALE DRAWING; REVISION; BREAK SHARP; DEBURR AND; SECTION A-A; SCALE 1 : 1

UNLESS OTHERWISE SPECIFIED:
DIMENSIONS ARE IN MILLIMETERS
SURFACE FINISH:
TOLERANCES:
LINEAR:
ANGULAR:

DRAWN | Ogweno | | 16/5/24

NAME | SIGNATURE | DATE | TITLE: Motor Components

APPV'D
MFG
MATERIAL: Bulkhead_Drawing Aluminium 6063 T6 | DWG NO. | A3 Q.A

WEIGHT: | SCALE:1:2 | SHEET 1 OF 1
