nakujaproject/internship2024-2/SOLID PROPULSION/code/LoadCellCal/LoadCellCal.ino

#include <HX711_ADC.h>



const int HX711_dout = 13; //mcu > HX711 dout pin, must be external interrupt capable!
const int HX711_sck = 32; //mcu > HX711 sck pin

//HX711 constructor:
HX711_ADC LoadCell(HX711_dout, HX711_sck);


unsigned long t = 0;
volatile boolean newDataReady;

void setup() {
  Serial.begin(57600); delay(10);
  Serial.println();
  Serial.println("Starting...");

  float calibrationValue; // calibration value
  calibrationValue = 5.5; // uncomment this if you want to set this value in the sketch

  LoadCell.begin();
  //LoadCell.setReverseOutput();
  unsigned long stabilizingtime = 2000; // tare preciscion can be improved by adding a few seconds of stabilizing time
  boolean _tare = true; //set this to false if you don't want tare to be performed in the next step
  LoadCell.start(stabilizingtime, _tare);
  if (LoadCell.getTareTimeoutFlag()) {
    Serial.println("Timeout, check MCU>HX711 wiring and pin designations");
    while (1);
  }
  else {
    LoadCell.setCalFactor(calibrationValue); // set calibration value (float)
    Serial.println("Startup is complete");
  }

  attachInterrupt(digitalPinToInterrupt(HX711_dout), dataReadyISR, FALLING);
}

//interrupt routine:
void dataReadyISR() {
  if (LoadCell.update()) {
    newDataReady = 1;
  }
}

void loop() {
  const int serialPrintInterval = 0; //increase value to slow down serial print activity

  // get smoothed value from the dataset:
  if (newDataReady) {
    if (millis() > t + serialPrintInterval) {
      float i = LoadCell.getData();
      newDataReady = 0;
      //Serial.print("Load_cell output val: ");
      //Serial.print(millis());
      //Serial.print(' ');
      Serial.println(i);
      //Serial.println("kg");
      
      //Serial.println("g");
      //Serial.print("  ");
      //Serial.println(millis() - t);
      t = millis();
    }
  }

  // receive command from serial terminal, send 't' to initiate tare operation:
  if (Serial.available() > 0) {
    char inByte = Serial.read();
    if (inByte == 't') LoadCell.tareNoDelay();
  }

  //check if last tare operation is complete
  if (LoadCell.getTareStatus() == true) {
    Serial.println("Tare complete");
  }

}
