nakujaproject/internship2024-2/(commit log)

2024-06-06 Create CAD FILE
2024-06-14 Create open motor simulation
